pymo/wch_micro_kbd/pcb/v3.1/BOM_v3_1_schematic3_1_2025-06-29.xlsx

No. | Quantity | Comment | Designator | Footprint | Value | Manufacturer Part | Manufacturer | Supplier Part | Supplier | JLCPCB Price | JLCPCB Stock
1 | 1 | K2-1809SN-A4DW-06 | BOOT | KEY-SMD_4P-L3.5-W3.0-P1.50-LS4.6 |  | K2-1809SN-A4DW-06 | 韩国韩荣 | C223823 | LCSC | 0.657 | 2903
2 | 3 | 2.2uF | C1,C4,C8 | C0603 | 2.2uF | CL10A225KO8NNNC | SAMSUNG(三星) | C23630 | LCSC | 0.0381 | 3934330
3 | 2 | 100nF | C2,C11 | C0402 | 100nF | CL05B104KO5NNNC | SAMSUNG(三星) | C1525 | LCSC | 0.0076 | 19395674
4 | 2 | 1uF | C3,C7 | C0402 | 1uF | CL05A105KA5NQNC | SAMSUNG(三星) | C52923 | LCSC | 0.0198 | 5595494
5 | 2 | 10uF | C9,C10 | C0603 | 10uF | CL10A106MA8NRNC | SAMSUNG(三星) | C96446 | LCSC | 0.12 | 4232449
6 | 1 | CH582F | CH582Fv3 | QFN-28_L4.0-W4.0-P0.40-BL-EP2.8 |  | CH582F | WCH(南京沁恒) | C3001175 | LCSC | 7.84 | 5346
7 | 1 | 1N5819WS | D2 | SOD-323_L1.8-W1.3-LS2.5-RD |  | 1N5819WS | Hottech(合科泰) | C191023 | LCSC | 0.0641 | 1997245
8 | 1 | ESDR0502NMUTBG | D3 | UDFN-6_L1.2-W1.0-P0.40-BL |  | ESDR0502NMUTBG | onsemi(安森美) | C327480 | LCSC | 1.104 | 30
9 | 1 | 22uH | L1 | IND-SMD_L2.0-W1.6_NR201610 | 22uH | YNR2016-220M | YJYCOIN(益嘉源) | C2858408 | LCSC | 0.382 | 5247
10 | 1 | F.0603.00026/P2-0603B1TS2-06T-001 | LED_BLUE | LED0603-RD |  | F.0603.00026/P2-0603B1TS2-06T-001 | TUOZHAN(拓展光电) | C7496819 | LCSC | 0.0238 | 130520
11 | 1 | F.0603.00025/P2-0603G1TS2-06T-002 | LED_GREEN | D-L1.6-W0.8-RD |  | F.0603.00025/P2-0603G1TS2-06T-002 | TUOZHAN(拓展光电) | C7496818 | LCSC | 0.0209 | 423623
12 | 1 | F.0603.00139/P2-0603R1TS2-06T-002 | LED_RED | LED0603-RD |  | F.0603.00139/P2-0603R1TS2-06T-002 | TUOZHAN(拓展光电) | C7496820 | LCSC | 0.0209 | 556630
13 | 1 | F.0603.00013/P2-0603Y1TS2-06T-001 | LED_YELLOW | LED0603-RD |  | F.0603.00013/P2-0603Y1TS2-06T-001 | TUOZHAN(拓展光电) | C7496811 | LCSC | 0.0377 | 7446
14 | 1 | MMBT3904 | Q1 | SOT-23-3_L2.9-W1.3-P1.90-LS2.4-BR |  | MMBT3904 | CJ(江苏长电/长晶) | C20526 | LCSC | 0.0624 | 912905
15 | 1 | AO3401A | Q2 | SOT-23_L2.9-W1.3-P1.90-LS2.4-BR |  | AO3401A | AOS | C15127 | LCSC | 0.361 | 341764
16 | 5 | 5.1kΩ | R1,R2,R12,R24,R27 | R0402 | 5.1kΩ | 0402WGF5101TCE | UNI-ROYAL(厚声) | C25905 | LCSC | 0.0031 | 3141394
17 | 4 | 470Ω | R3,R14,R15,R18 | R0402 | 470Ω | 0402WGF4700TCE | UNI-ROYAL(厚声) | C25117 | LCSC | 0.0035 | 1611008
18 | 7 | 100kΩ | R9,R10,R19,R20,R21,R28,R29 | R0402 | 100kΩ | 0402WGF1003TCE | UNI-ROYAL(厚声) | C25741 | LCSC | 0.0035 | 10119626
19 | 3 | 1MΩ | R16,R22,R23 | R0402 | 1MΩ | 0402WGF1004TCE | UNI-ROYAL(厚声) | C26083 | LCSC | 0.0037 | 4028425
20 | 1 | ME6214C33M5G | U5 | SOT-23-5_L3.0-W1.7-P0.95-LS2.8-BL |  | ME6214C33M5G | MICRONE(南京微盟) | C76500 | LCSC | 0.569 | 17420
21 | 1 | YTC-TC16-32 | U6 | USB-TYPE-C-SMD_YTC-TC16-32 |  | YTC-TC16-32 | YIYUAN(怡远) | C2927297 | LCSC | 0.858 | 743
22 | 1 | TP4054-42-SOT25R | U7 | SOT-23-5_L3.0-W1.7-P0.95-LS2.8-BL |  | TP4054-42-SOT25R | TOPPOWER(南京拓微) | C32574 | LCSC | 0.853 | 45212
23 | 1 | 32MHz | X1 | OSC-SMD_4P-L2.0-W1.6-BL | 32MHz | X201632MMB4SI | YXC(扬兴晶振) | C383840 | LCSC | 0.649 | 872
