pymo/wch_micro_kbd/pcb/v3.1/schematic_v3.1.pdf

# 图页EP 29

# MCU

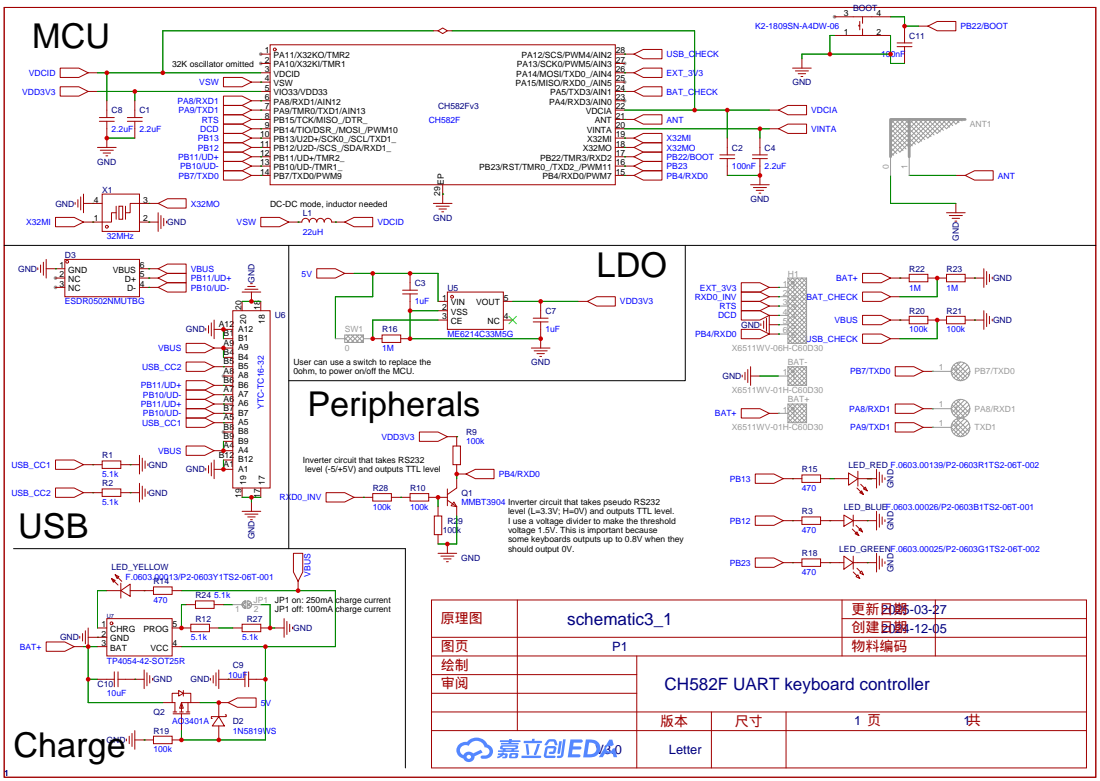
[picture p6: page 1]

User can use a switch to replace the
0ohm, to power on/off the MCU.

Inverter circuit that takes RS232
level (-5/+5V) and outputs TTL level

Inverter circuit that takes pseudo RS232
level (L=3.3V; H=0V) and outputs TTL level.
I use a voltage divider to make the threshold
voltage 1.5V. This is important because
some keyboards outputs up to 0.8V when they
