pymo/wch_micro_kbd/src/drivers/RF_PHY/rf_hop.h

/**
 * @brief 
 * 
 * @copyright Copyright (c) 2022 zerosensei
 * 
 */
#ifndef __RF_HOP_H
#define __RF_HOP_H

#include "rf_trans.h"
#include "rf_sync.h"

void rf_hop_start(void);
void rf_hop_end(void);
void rf_hop(void);

#endif /* __RF_HOP_H */
