pymo/wch_micro_kbd/src/drivers/RF_PHY/rf_port.h

/**
 * @file rf_port.h
 * 
 * @copyright Copyright (c) 2022 zerosensei
 * 
 */
#ifndef __RF_PORT_H
#define __RF_PORT_H

#include "rf_trans.h"
#include "rf_sync.h"

#ifndef CONFIG_RF_DEV_RCV_WINDOW_US
#define CONFIG_RF_DEV_RCV_WINDOW_US     100
#endif

enum rf_dev{
    RF_DEV_KBD,
    RF_DEV_MOUSE,

    RF_ALL_DEV,
};


enum rf_state {
    RF_DISCONNECTED,
    RF_CONNECTED,
};

struct rf_port_cb {
    void (*req_pair_cb)(uint8_t *data, uint8_t len);
    void (*req_key_cb)(uint8_t *data, uint8_t len);
    void (*connect_state_changed)(uint8_t state);
};


static inline uint8_t count_bit1(uint8_t val)
{
    uint8_t temp = val;
    uint8_t count = 0;
    while(temp){
        temp = temp & (temp - 1);
        count++;
    }
    return count;
}

bool rf_port_is_data_loaded(void);
int rf_port_load_data(uint8_t type, uint8_t *data, size_t len);
void rf_port_rcv_open(int timeout);
void rf_port_init(struct rf_port_cb *cb);

#endif /* __RF_PORT_H */
