pymo/wch_micro_kbd/src/drivers/key_scan/key_codes.h

/*
 * key_codes.h
 *
 *  Created on: Dec 26, 2023
 *      Author: Xinming Chen
 */

#ifndef DRIVERS_KEY_SCAN_KEY_CODES_H_
#define DRIVERS_KEY_SCAN_KEY_CODES_H_


/// Keyboard modifier codes bitmap
#define KEYBOARD_MODIFIER_LEFTCTRL   0b00000001 ///< Left Control
#define KEYBOARD_MODIFIER_LEFTSHIFT  0b00000010 ///< Left Shift
#define KEYBOARD_MODIFIER_LEFTALT    0b00000100 ///< Left Alt
#define KEYBOARD_MODIFIER_LEFTGUI    0b00001000 ///< Left Window
#define KEYBOARD_MODIFIER_RIGHTCTRL  0b00010000 ///< Right Control
#define KEYBOARD_MODIFIER_RIGHTSHIFT 0b00100000 ///< Right Shift
#define KEYBOARD_MODIFIER_RIGHTALT   0b01000000 ///< Right Alt
#define KEYBOARD_MODIFIER_RIGHTGUI   0b10000000 ///< Right Window

//--------------------------------------------------------------------+
// HID KEYCODE
//--------------------------------------------------------------------+
#define HID_KEY_NONE               0x00
#define HID_KEY_A                  0x04
#define HID_KEY_B                  0x05
#define HID_KEY_C                  0x06
#define HID_KEY_D                  0x07
#define HID_KEY_E                  0x08
#define HID_KEY_F                  0x09
#define HID_KEY_G                  0x0A
#define HID_KEY_H                  0x0B
#define HID_KEY_I                  0x0C
#define HID_KEY_J                  0x0D
#define HID_KEY_K                  0x0E
#define HID_KEY_L                  0x0F
#define HID_KEY_M                  0x10
#define HID_KEY_N                  0x11
#define HID_KEY_O                  0x12
#define HID_KEY_P                  0x13
#define HID_KEY_Q                  0x14
#define HID_KEY_R                  0x15
#define HID_KEY_S                  0x16
#define HID_KEY_T                  0x17
#define HID_KEY_U                  0x18
#define HID_KEY_V                  0x19
#define HID_KEY_W                  0x1A
#define HID_KEY_X                  0x1B
#define HID_KEY_Y                  0x1C
#define HID_KEY_Z                  0x1D
#define HID_KEY_1                  0x1E
#define HID_KEY_2                  0x1F
#define HID_KEY_3                  0x20
#define HID_KEY_4                  0x21
#define HID_KEY_5                  0x22
#define HID_KEY_6                  0x23
#define HID_KEY_7                  0x24
#define HID_KEY_8                  0x25
#define HID_KEY_9                  0x26
#define HID_KEY_0                  0x27
#define HID_KEY_RETURN             0x28
#define HID_KEY_ESCAPE             0x29
#define HID_KEY_BACKSPACE          0x2A
#define HID_KEY_TAB                0x2B
#define HID_KEY_SPACE              0x2C
#define HID_KEY_MINUS              0x2D
#define HID_KEY_EQUAL              0x2E
#define HID_KEY_BRACKET_LEFT       0x2F
#define HID_KEY_BRACKET_RIGHT      0x30
#define HID_KEY_BACKSLASH          0x31
#define HID_KEY_EUROPE_1           0x32
#define HID_KEY_SEMICOLON          0x33
#define HID_KEY_APOSTROPHE         0x34
#define HID_KEY_GRAVE              0x35
#define HID_KEY_COMMA              0x36
#define HID_KEY_PERIOD             0x37
#define HID_KEY_SLASH              0x38
#define HID_KEY_CAPS_LOCK          0x39
#define HID_KEY_F1                 0x3A
#define HID_KEY_F2                 0x3B
#define HID_KEY_F3                 0x3C
#define HID_KEY_F4                 0x3D
#define HID_KEY_F5                 0x3E
#define HID_KEY_F6                 0x3F
#define HID_KEY_F7                 0x40
#define HID_KEY_F8                 0x41
#define HID_KEY_F9                 0x42
#define HID_KEY_F10                0x43
#define HID_KEY_F11                0x44
#define HID_KEY_F12                0x45
#define HID_KEY_PRINT_SCREEN       0x46
#define HID_KEY_SCROLL_LOCK        0x47
#define HID_KEY_PAUSE              0x48
#define HID_KEY_INSERT             0x49
#define HID_KEY_HOME               0x4A
#define HID_KEY_PAGE_UP            0x4B
#define HID_KEY_DELETE             0x4C
#define HID_KEY_END                0x4D
#define HID_KEY_PAGE_DOWN          0x4E
#define HID_KEY_ARROW_RIGHT        0x4F
#define HID_KEY_ARROW_LEFT         0x50
#define HID_KEY_ARROW_DOWN         0x51
#define HID_KEY_ARROW_UP           0x52
#define HID_KEY_NUM_LOCK           0x53
#define HID_KEY_KEYPAD_DIVIDE      0x54
#define HID_KEY_KEYPAD_MULTIPLY    0x55
#define HID_KEY_KEYPAD_SUBTRACT    0x56
#define HID_KEY_KEYPAD_ADD         0x57
#define HID_KEY_KEYPAD_ENTER       0x58
#define HID_KEY_KEYPAD_1           0x59
#define HID_KEY_KEYPAD_2           0x5A
#define HID_KEY_KEYPAD_3           0x5B
#define HID_KEY_KEYPAD_4           0x5C
#define HID_KEY_KEYPAD_5           0x5D
#define HID_KEY_KEYPAD_6           0x5E
#define HID_KEY_KEYPAD_7           0x5F
#define HID_KEY_KEYPAD_8           0x60
#define HID_KEY_KEYPAD_9           0x61
#define HID_KEY_KEYPAD_0           0x62
#define HID_KEY_KEYPAD_DECIMAL     0x63
#define HID_KEY_EUROPE_2           0x64
#define HID_KEY_APPLICATION        0x65  // Menu key
#define HID_KEY_POWER              0x66
#define HID_KEY_KEYPAD_EQUAL       0x67
#define HID_KEY_F13                0x68
#define HID_KEY_F14                0x69
#define HID_KEY_F15                0x6A
#define HID_KEY_F16                0x6B
#define HID_KEY_F17                0x6C
#define HID_KEY_F18                0x6D
#define HID_KEY_F19                0x6E
#define HID_KEY_F20                0x6F
#define HID_KEY_F21                0x70
#define HID_KEY_F22                0x71
#define HID_KEY_F23                0x72
#define HID_KEY_F24                0x73
#define HID_KEY_CONTROL_LEFT       0xE0
#define HID_KEY_SHIFT_LEFT         0xE1
#define HID_KEY_ALT_LEFT           0xE2
#define HID_KEY_GUI_LEFT           0xE3
#define HID_KEY_CONTROL_RIGHT      0xE4
#define HID_KEY_SHIFT_RIGHT        0xE5
#define HID_KEY_ALT_RIGHT          0xE6
#define HID_KEY_GUI_RIGHT          0xE7

// The following are not in HID spec, but I defined it for convenience.

// a placeholder to indicate the start of custom-defined code. Add new code below it and adjust this value accordingly
#define HID_KEY_SPECIAL_START_INDEX 0xED

#define HID_KEY_EMAIL 0xEE
#define HID_KEY_CALCULATOR 0xEF
#define HID_KEY_VOL_DEC 0xF0
#define HID_KEY_VOL_INC 0xF1
#define HID_KEY_BRIGHTNESS_DEC 0xF2
#define HID_KEY_BRIGHTNESS_INC 0xF3
#define HID_KEY_PLAY 0xF4
#define HID_KEY_PREVIOUS 0xF5
#define HID_KEY_NEXT 0xF6
#define HID_KEY_WWW_HOME 0xF7
#define HID_KEY_WWW_BACK 0xF8

// Keyboard mode and FN key code for convenience.
#define HID_KEY_MODE_USB 0xF9
#define HID_KEY_MODE_BLE_CHAN_1 0xFA
#define HID_KEY_MODE_BLE_CHAN_2 0xFB
#define HID_KEY_MODE_BLE_CHAN_3 0xFC
#define HID_KEY_MODE_BLE_CHAN_4 0xFD
#define HID_KEY_FN             0xFE
#define HID_KEY_FN2              0xFF


#endif /* DRIVERS_KEY_SCAN_KEY_CODES_H_ */
