pymo/wch_micro_kbd/(commit log)

2024-02-19 Forked from official Three-mode_kbd demo
    [wch-interface.cfg, wch-target.cfg]
2024-05-20 First working prototype with PPK
2024-06-12 Sleep and LED driver done
2024-06-16 ADC battery function
2024-06-17 Enable ADC sampling
2024-07-04 Fixed bonding issue. Fixed battery update. Removed Numlock support
    [ADC.h, battservice.c, hiddev.c, keyscan.c]
2024-10-15 hw 2.0 pcb files and firmware
    [BOM_v2_schematic1_6_2024-10-15.xlsx, PickAndPlace_PCB1_11_2024-10-15.xlsx]
2025-02-28 Updates v3 PCB photo
2025-06-29 Adds PCB v3
    [BOM_v3_1_schematic3_1_2025-06-29.xlsx, PickAndPlace_PCB1_14_2025-06-29.xlsx]
